xosk31/PlotterXY/Firmware/Codigo/PinConexiones.md

 
### Motor eje X

| Motor X | X_STEP_PIN | X_DIR_PIN | X_ENABLE_PIN | MS1PINX | MS2PINX | MS3PINX |
| :---: | :---: | :---: | :---: | :---:  | :---: | :---: |
| **PIN**  | 54 | 55 | 38 | 40 | 42 | 44 |

### Motor eje Y

| Motor Y | Y_STEP_PIN | Y_DIR_PIN | Y_ENABLE_PIN | MS1PINY | MS2PINY | MS3PINY |
| :---: | :---: | :---: | :---: | :---:  | :---: | :---: |
| **PIN**  | 60 | 61 | 56 | 63 | 59 | 64 |

### Conmutadores

| Conmutadores | X_MIN_PIN | X_MAX_PIN | Y_MIN_PIN | Y_MAX_PIN | 
| :---: | :---: | :---: | :---: | :---:  |
| **PIN**  | 19 | 20 | 18 | 21 | 

### Servo

| Servo | SERVO_PIN | 
| :---: | :---: |
| **PIN**  | 4 | 

## Full Graphic Smart Controller

### LCD

| LCD | RS | ENABLE | SCLK | 
| :---: | :---: | :---: | :---: |
| **PIN**  | 16 | 17 | 23 | 

### SD

| SD | SS | SCK | MOSI | MISO | SDDETECT | 
| :---: | :---: | :---: | :---: | :---:  | :---: |
| **PIN**  | 53 | 52 | 51 | 50 | 49 |  

### Encoder

| Encoder | KEY_PREV | KEY_NEXT | KEY_SELECT | 
| :---: | :---: | :---: | :---: |
| **PIN**  | 31 | 33 | 35 | 

### Pulsador

| Pulsador | KEY_CONFIRM | 
| :---: | :---: |
| **PIN**  | 41 |  

### Zumbador

| Beeper | BEEPER_PIN | 
| :---: | :---: |
| **PIN**  | 37 |
