xosk31/PlotterXY/Firmware/Codigo/LibreriasNecesarias.md

# Librerías necesarias para Plotter XY

**SD.h** de Arduino: referencia en https://www.arduino.cc/en/Reference/SD

**Servo.h** de Arduino: referencia en: https://www.arduino.cc/en/Reference/Servo

**U8glib.h** de olikraus: referencia en: https://github.com/olikraus/u8glib
