xosk31/PlotterXY/Hardware/EsquemaGeneral/EsquemaGeneralHW.md

## Esquema General HW

Atendiendo a los recursos y especificaciones HW requeridas se elabora el siguiente esquema general 
del conexionado que permite la visualización global del conjunto del diseño.

Esquema General Hardware
