xosk31/PlotterXY/Software/EsquemaGeneral/EsquemaGeneralSW.md

## Esquema General SW

Una vez calibrado y conectado el HW se procede a detallar las implementaciones SW llevadas a cabo. En primer lugar, 
se presenta un esquema general de los requisitos específicos del SW y seguidamente, 
se ofrecerá información detallada del algoritmo desarrollado para el tratamiento de imágenes.

El SW de este proyecto es una pieza clave ya que dota al sistema de los datos y las configuraciones necesarias para que el Firmware, 
PlotterXY, sea capaz de interpretarlos y coordinarlos con el HW. La implementación consiste en la elaboración de un 
algoritmo de transformación de imágenes, partiendo de cualquier formato, que convierte la información de la ilustración en valores 
de coordenadas X e Y que se almacenan en un fichero de datos con extensión .txt. Para la visualización global de la 
implementación se elabora la siguiente Figura:

esquemasoftware1

Para realizar esta transformación se utilizan varios entornos gráficos libres y de código abierto: Inkscape, para la edición de vectores gráficos y NetBeans, como entorno de desarrollo integrado simple.
