xosk31/PlotterXY/Software/Codigo/Codigo.md

Código de Algoritmo de transformacion de imágenes.rar

Ejecutar en NetBeans

Disponibles archivos de calibración
