xosk31/PlotterXY/Software/Codigo/Calibracion/Calibracion.md

## Archivos de Calibración

Para calibrar el Firmware se adjuntan los archivos de calibración con ejemplos de diversas impresiones en EjemplosCalibracion.rar.

Entre ellos se encuentran:

* **Escaleras:** el comportamiento del sistema frente a trazados simétricos en los ejes X e Y.
- **Espiral:** el comportamiento del sistema frente a cambios bruscos en la dirección de los ejes X e Y.
- **Escala:** el comportamiento del sistema frente a las distintas escalas seleccionables manualmente.
- **Círculos** comportamiento del sistema frente a trazados circulares.
- **Figuras:** figuras geométricas realizadas mediante Inkscape, enfocadas al análisis de diferentes formas empleadas en los diseños.
- **Letras:** la impresión del alfabeto español, para determinar la precisión de escritura de textos.
- **Batman:** figuras preparadas para máquinas CNC.
